HardlightVR/HL-hardware/Fabrics/NULLSPACEVR-TECH-PACK.pdf

CATEGORY | PRODUCT | | DATE | 2/20/16 | FABRICATION | 1 TRIMS | YKK 17" ZIP X1
HAPTIC WEAR | MARK IIc CONCEPT | JACKET | M/F | N/A | | 2 | 1 1/2" WIDE FLAT RIBBON
PRODUCTION FACILITY | | | SIZES | OS | | 3 | 2" WIDE VELCRO
| | | | | | | 2" WIDE ELASTIC

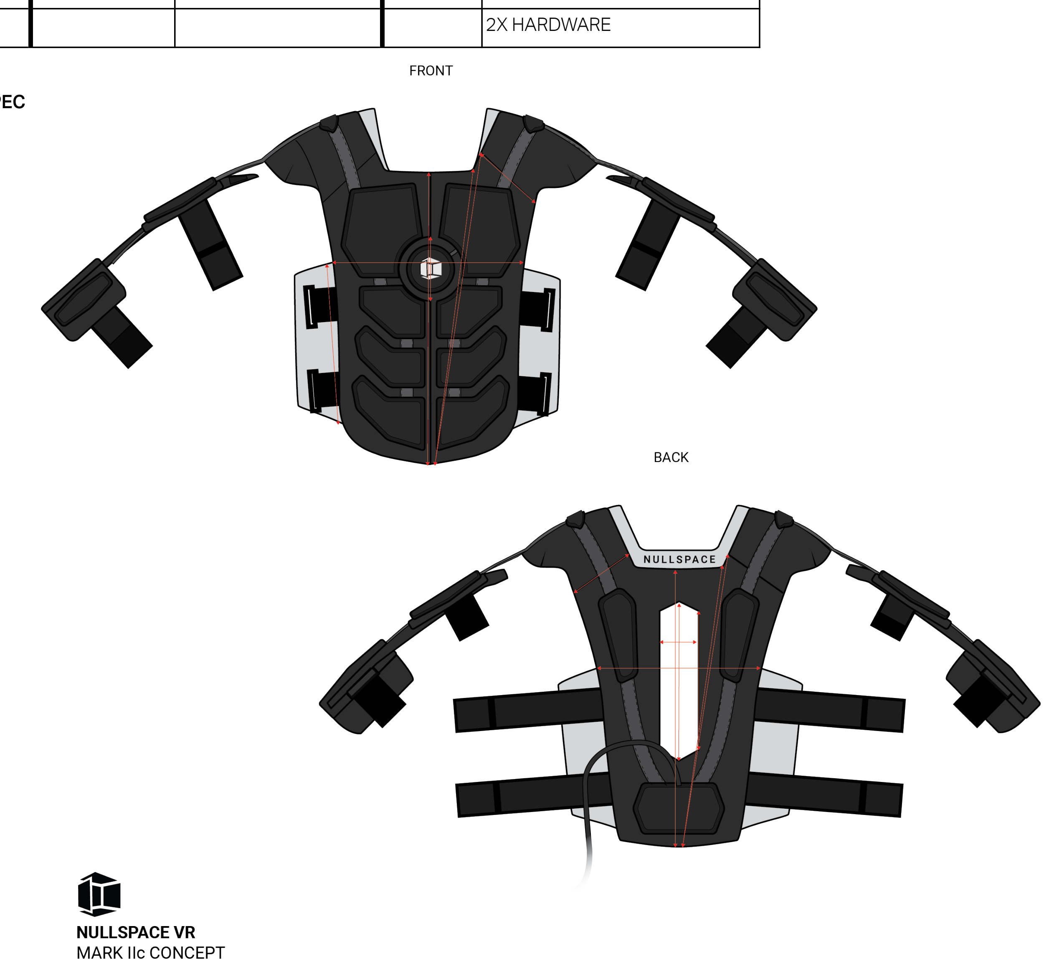
[picture p1: figure]
2X HARDWARE

INCHES | 1st FIT | APPROVED SPEC
CENTER FRONT NECK TO HEM | 17
BODY LENGTH TO CORNER NECK (FRONT) | 17 3/8
BODY LENGTH TO SHOULDERS (FRONT) | 19 3/4
CENTER BACK NECK TO HEM | 15 7/8
BODY LENGTH TO CORNER NECK (BACK) | 16 1/4
BODY LENGTH TO SHOULDERS (BACK) | 18 1/4
ACROSS SHOULDERS (WIDEST POINT) | 6
CHEST AT 6" FROM RAGLAN SHOULDER SEAM FRONT | 10.5
CHEST AT 6" FROM RAGLAN SHOULDER SEAM BACK | 9 3/4
SHOULDER PANEL RAGLAN SEAM FRONT | 3.5
SHOULDER PANEL RAGLAN SEAM BACK | 3.5
BACK DIAMOND OPENING WIDTH | 2 5/8
BACK DIAMOND OPENING CENTER LENGTH | 9
BACK DIAMOND OPENING EDGE LENGTH | 7.5
SEAM ALLOWANCE | 1/2
EXCEPT: OUTSIDE EDGES | 3/8"

### NULL SPACE VR

### MEASUREMENT (SEAM TO SEAM)
