HardlightVR/HL-hardware/Cables/Cable BOM.xlsx

Shorthand | Description | Digikey # | Manufacturer | Manufacturer #
16 pin header | CONN PLUG DUAL 16CKT BEIGE | WM13364-ND | Molex | 5031491600
8 pin header | CONN PLUG DUAL 8POS BEIGE | WM13361-ND | Molex | 5031490800
6 pin header, 2mm spacing | CONN PLUG HOUSING 6POS 2.00MM | WM2275-ND | Molex | 5024390600
4 pin header | CONN PLUG HSG 4CKT BEIGE | WM13352-ND | Molex | 5025780400
little crimps | CONN PLUG TERM 24-28AWG | WM9735CT-ND | Molex | 5025790000
big crimps for 6 pin | CONN TERM PLUG 22-26AWG CRIMP | WM3978CT-ND | Molex | 5024380000
TE 2 pin header for motors | CONN RECPT 2POS .1" POL UNLOAD | A28393-ND | TE Connectivity | 104257-1
TE crimp socket | CONN SOCKET 22-26AWG TIN CRIMP | A100411CT-ND | TE Connectivity | 1-104480-7
