HardlightVR/HL-hardware/Backpack Adapters/MSI/Backpack_Assm.SLDASM

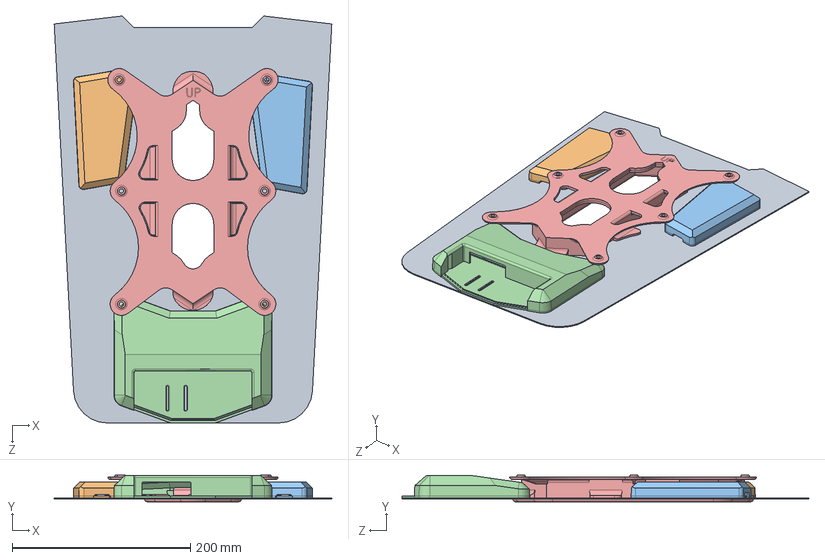
[picture p2: CAD file, 2019-01-10]
Backpack Adapters/MSI/Backpack_Assm.SLDASM
311.9 x 29.8 x 457.2 mm
Back_plate_guess
UpperBack_L
UpperBack_R
Lower Back_forWireless
MSI
