HardlightVR/HL-hardware/Backpack Adapters/HP OMEN/hp_adapter_plate.stl

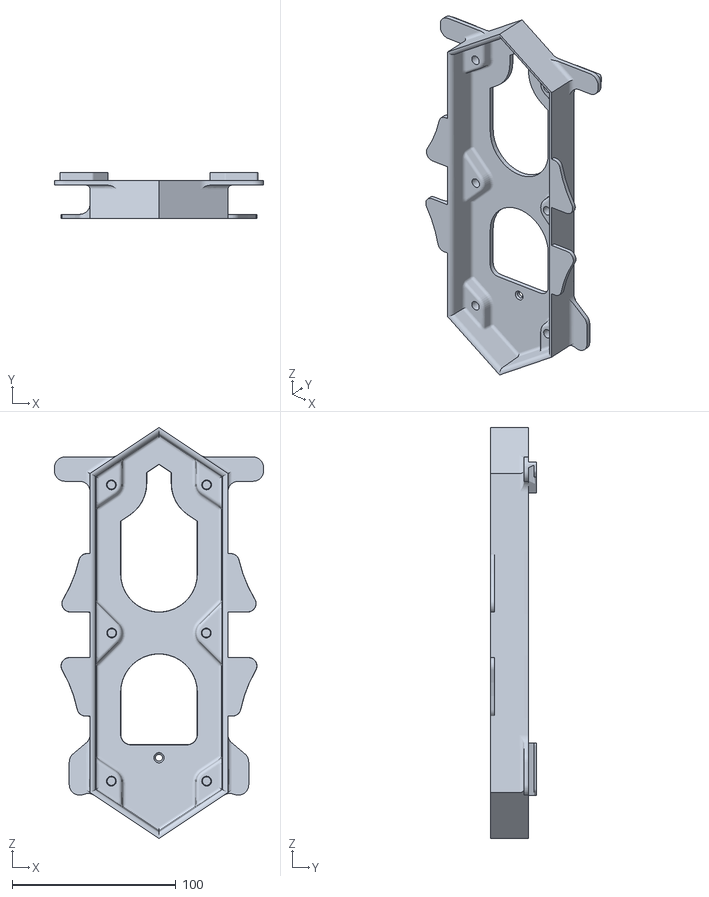
[picture p3: CAD file, 2019-01-10]
Backpack Adapters/HP OMEN/hp_adapter_plate.stl
127.7 x 28.0 x 250.9
