HardlightVR/HL-hardware/Backpack Adapters/ZOTAC/Zotac_Adapter.STL

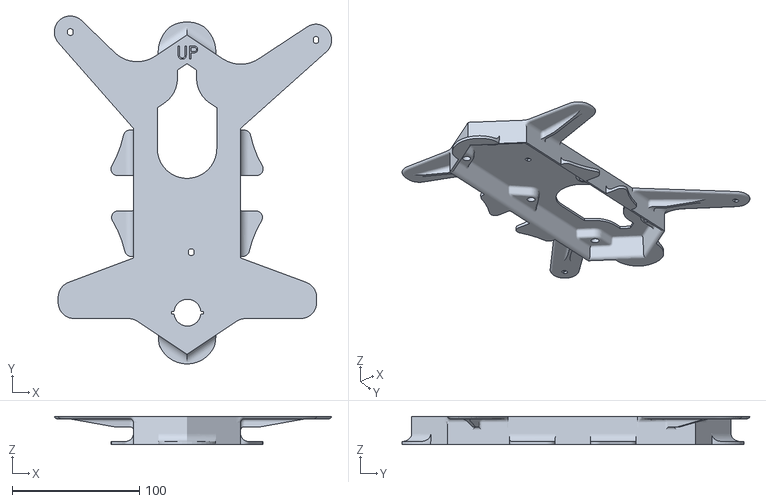
[picture p4: CAD file, 2019-01-10]
Backpack Adapters/ZOTAC/Zotac_Adapter.STL
218.0 x 273.4 x 22.3
