HardlightVR/HL-hardware/Final Plastics/UpperBack_L_cover.STEP

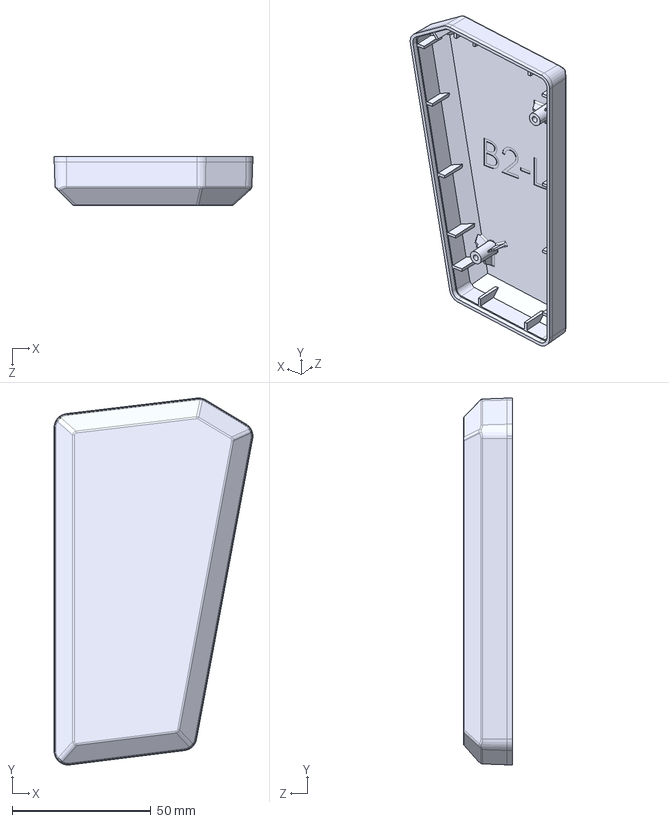
[picture p5: CAD file, 2019-01-10]
Final Plastics/UpperBack_L_cover.STEP
71.8 x 132.4 x 17.8 mm
