HardlightVR/HL-hardware/Prototype Plastics/Assem chest middle.STEP

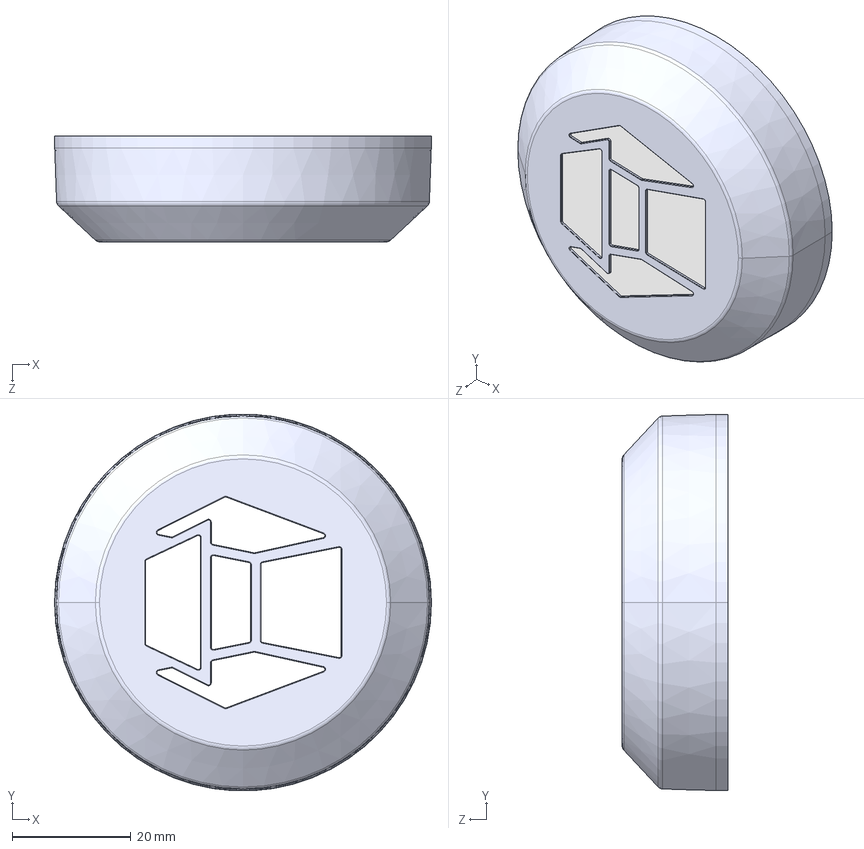
[picture p6: CAD file, 2019-01-10]
Prototype Plastics/Assem chest middle.STEP
63.4 x 63.3 x 17.8 mm
Chest_Middle_cover___
Chest_Middle_cover_glass___
