HardlightVR/HL-hardware/Prototype Plastics/VR 3d drawing-0815/assem shoulder.STEP

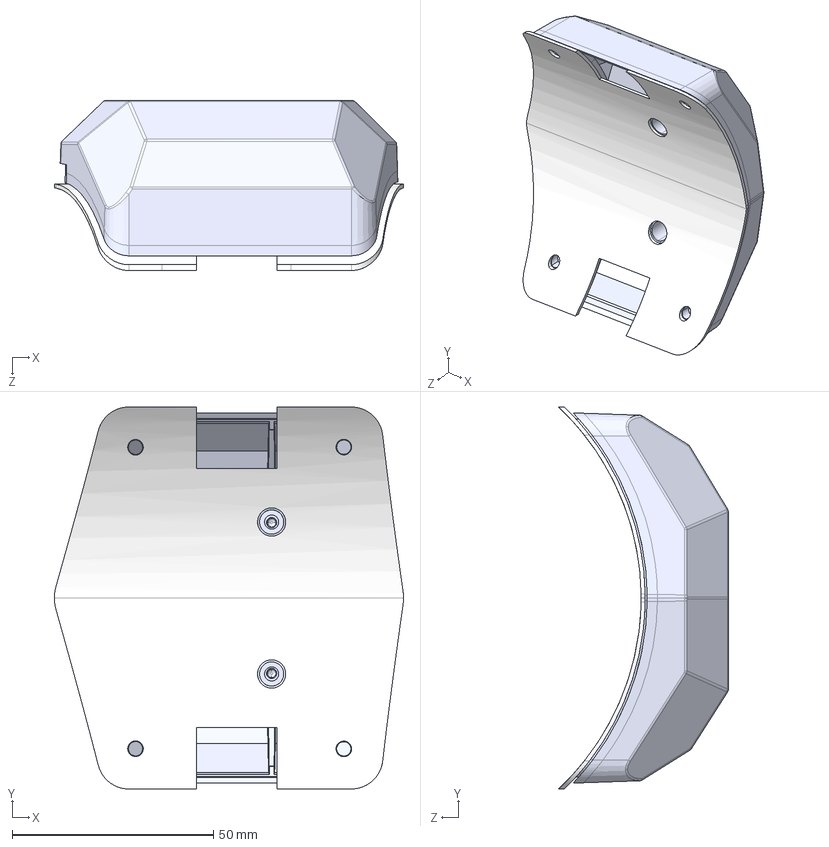
[picture p7: CAD file, 2019-01-10]
Prototype Plastics/VR 3d drawing-0815/assem shoulder.STEP
86.7 x 94.8 x 42.2 mm
Shoulder_base___
Shoulder_cover___
shoulder_Stif___
