HardlightVR/HL-hardware/Backpack Adapters/HP OMEN/hp_adapter_plate_latch.stl

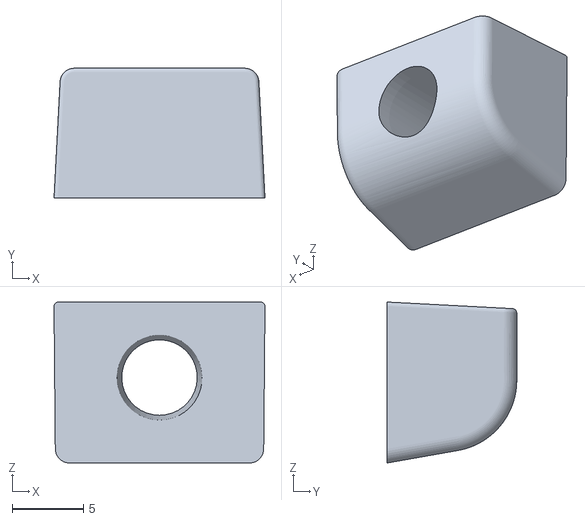
[picture p8: CAD file, 2019-01-10]
Backpack Adapters/HP OMEN/hp_adapter_plate_latch.stl
14.8 x 9.10 x 11.3
