HardlightVR/HL-hardware/Backpack Adapters/MSI/UpperBack_R.SLDPRT

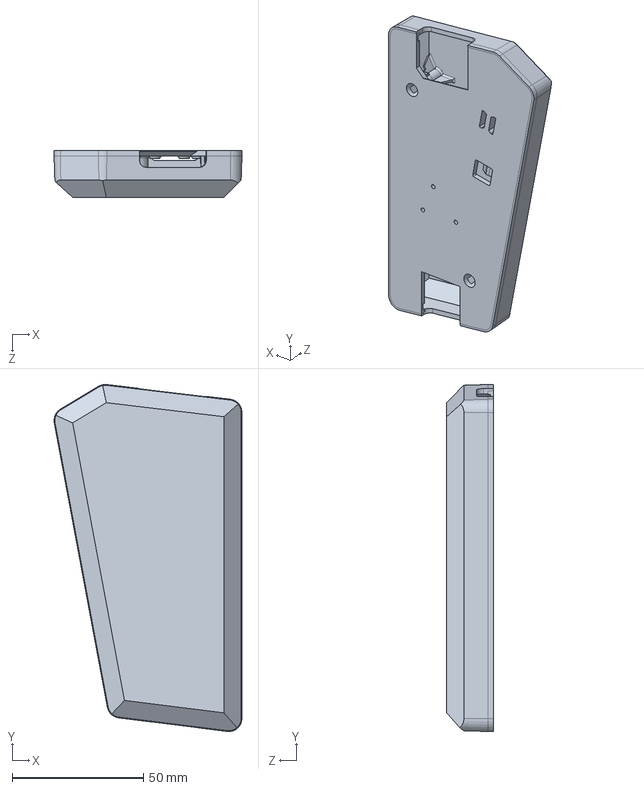
[picture p9: CAD file, 2019-01-10]
Backpack Adapters/MSI/UpperBack_R.SLDPRT
71.7 x 132.3 x 17.8 mm
