HardlightVR/HL-hardware/Backpack Adapters/ZOTAC/Zotac_Clamp.STL

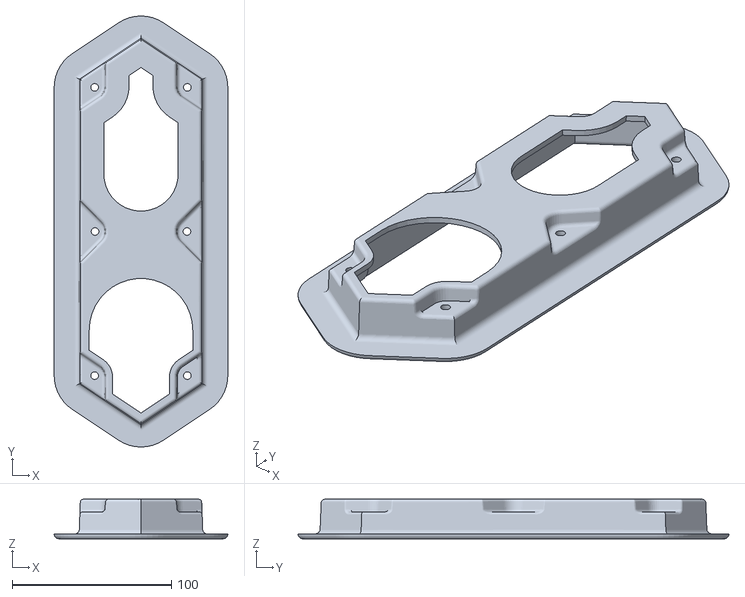
[picture p10: CAD file, 2019-01-10]
Backpack Adapters/ZOTAC/Zotac_Clamp.STL
109.0 x 270.5 x 24.8
