HardlightVR/HL-hardware/Prototype Plastics/Assem upper back_R.STEP

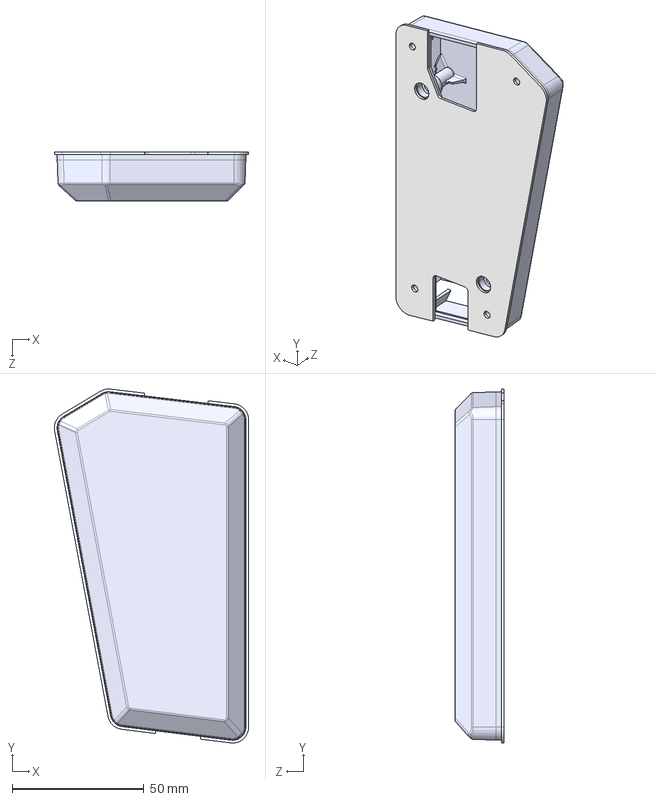
[picture p11: CAD file, 2019-01-10]
Prototype Plastics/Assem upper back_R.STEP
73.8 x 134.5 x 18.8 mm
UpperBack_L_base_R
UpperBack_L_cover-170629_R
UpperBack_L_Stif___
