HardlightVR/HL-hardware/Backpack Adapters/MSI/Lower Back_forWireless.SLDPRT

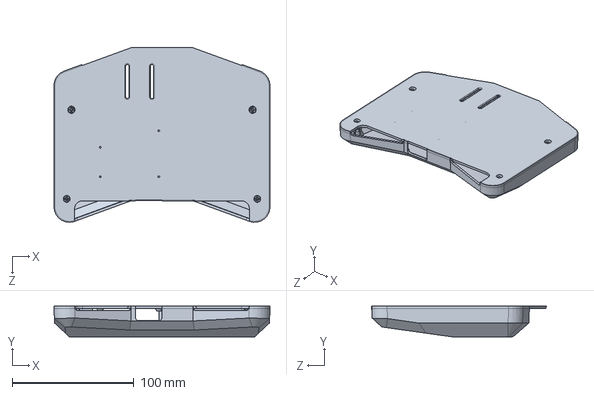
[picture p12: CAD file, 2019-01-10]
Backpack Adapters/MSI/Lower Back_forWireless.SLDPRT
177.7 x 25.4 x 143.7 mm
