HardlightVR/HL-hardware/Prototype Plastics/VR 3d drawing-0815/Assem lowerback.STEP

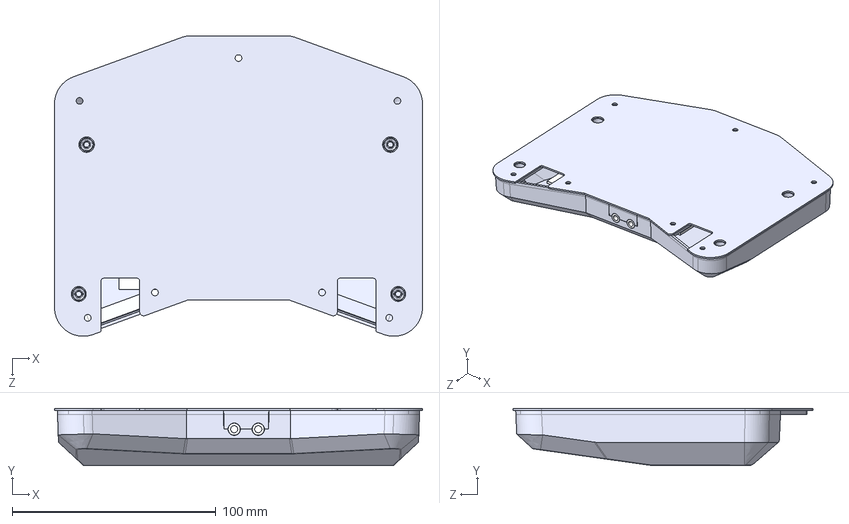
[picture p13: CAD file, 2019-01-10]
Prototype Plastics/VR 3d drawing-0815/Assem lowerback.STEP
180.6 x 28.0 x 147.5 mm
Lower Back_forWireless-base
Lower Back_forWireless-cover
MAIN PCBA___
lower back forWireless-Stif
