HardlightVR/HL-hardware/Backpack Adapters/MSI/Back_plate_guess.SLDPRT

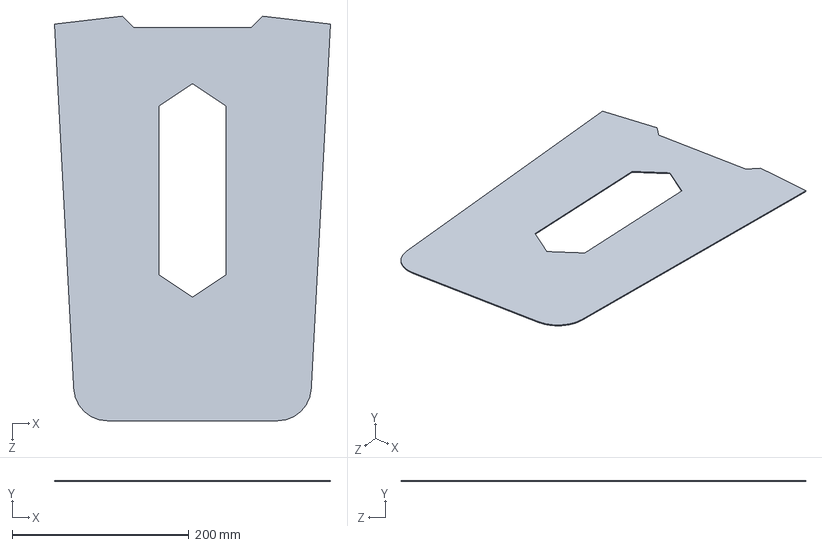
[picture p14: CAD file, 2019-01-10]
Backpack Adapters/MSI/Back_plate_guess.SLDPRT
311.9 x 1.27 x 457.2 mm
