HardlightVR/HL-hardware/Final Plastics/TopAb_L_Stif.STEP

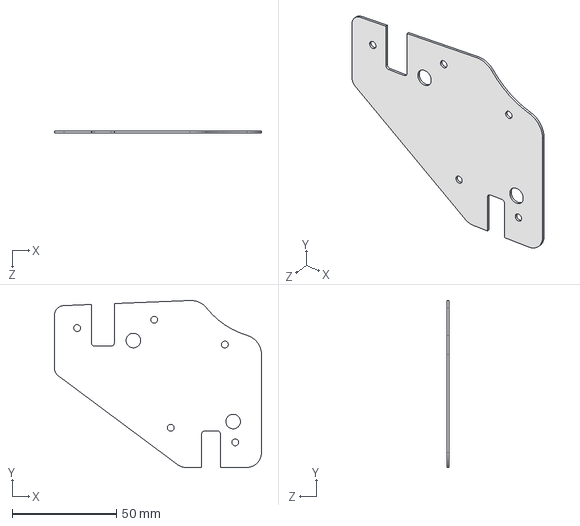
[picture p15: CAD file, 2019-01-10]
Final Plastics/TopAb_L_Stif.STEP
99.5 x 80.3 x 1.00 mm
