HardlightVR/HL-hardware/Prototype Plastics/VR 3d drawing-0815/Assm arm.STEP

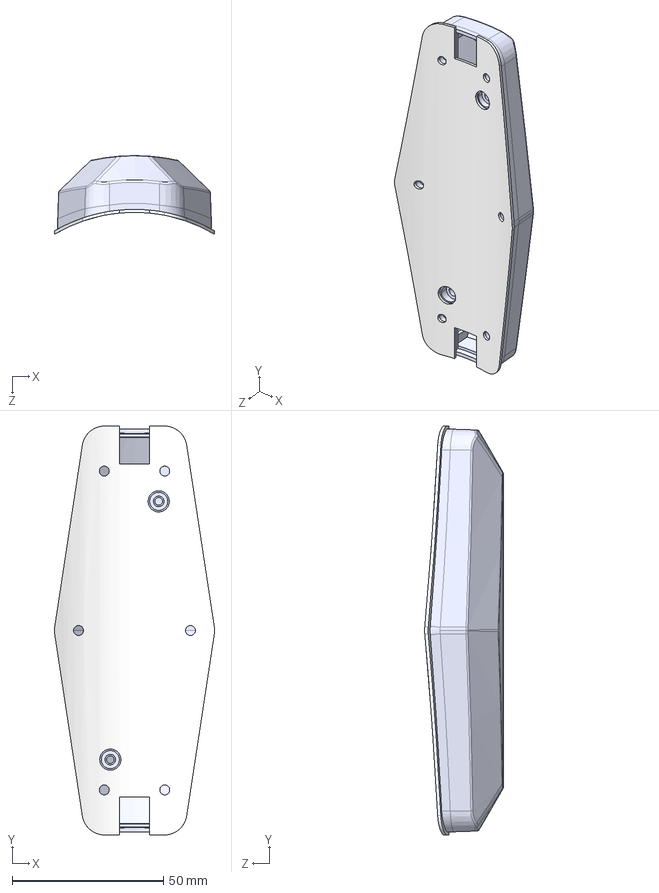
[picture p16: CAD file, 2019-01-10]
Prototype Plastics/VR 3d drawing-0815/Assm arm.STEP
53.0 x 135.2 x 26.1 mm
Arm_base___
Arm_cover___
vibration motor___
Arm_Stif___
