HardlightVR/HL-hardware/Final Plastics/BotAb_L_cover.STEP

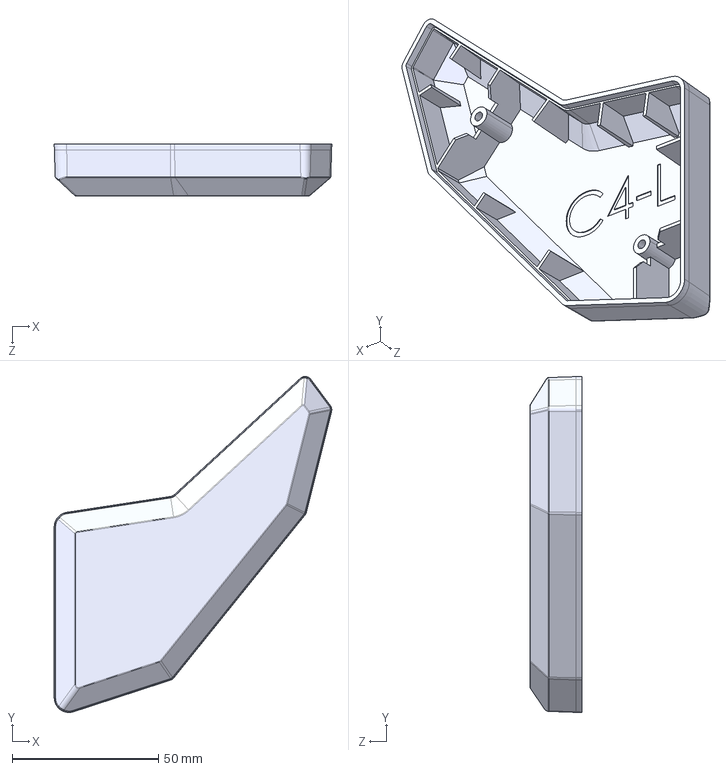
[picture p17: CAD file, 2019-01-10]
Final Plastics/BotAb_L_cover.STEP
95.0 x 115.0 x 17.8 mm
