HardlightVR/HL-hardware/Final Plastics/Shoulder_cover.STEP

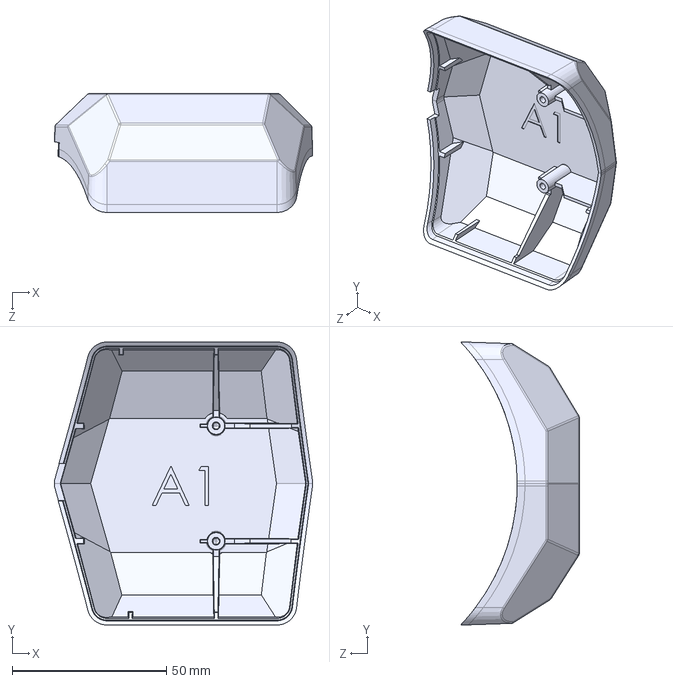
[picture p18: CAD file, 2019-01-10]
Final Plastics/Shoulder_cover.STEP
83.8 x 91.8 x 38.6 mm
