HardlightVR/HL-hardware/Final Plastics/UpperBack_L_Stif.STEP

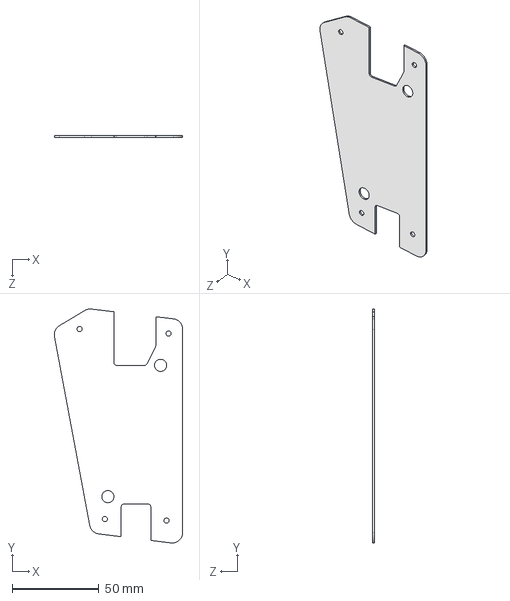
[picture p19: CAD file, 2019-01-10]
Final Plastics/UpperBack_L_Stif.STEP
73.8 x 134.5 x 1.00 mm
