HardlightVR/HL-hardware/Final Plastics/TopAb_L_base.STEP

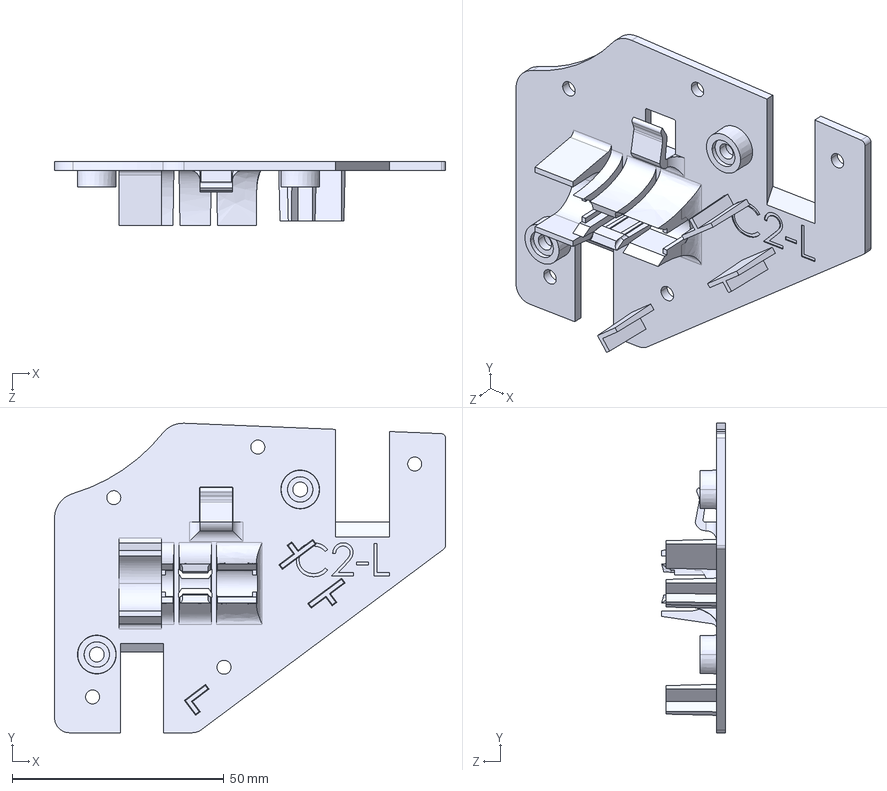
[picture p20: CAD file, 2019-01-10]
Final Plastics/TopAb_L_base.STEP
92.2 x 73.0 x 15.0 mm
