HardlightVR/HL-hardware/Final Plastics/Chest_R_Stif.STEP

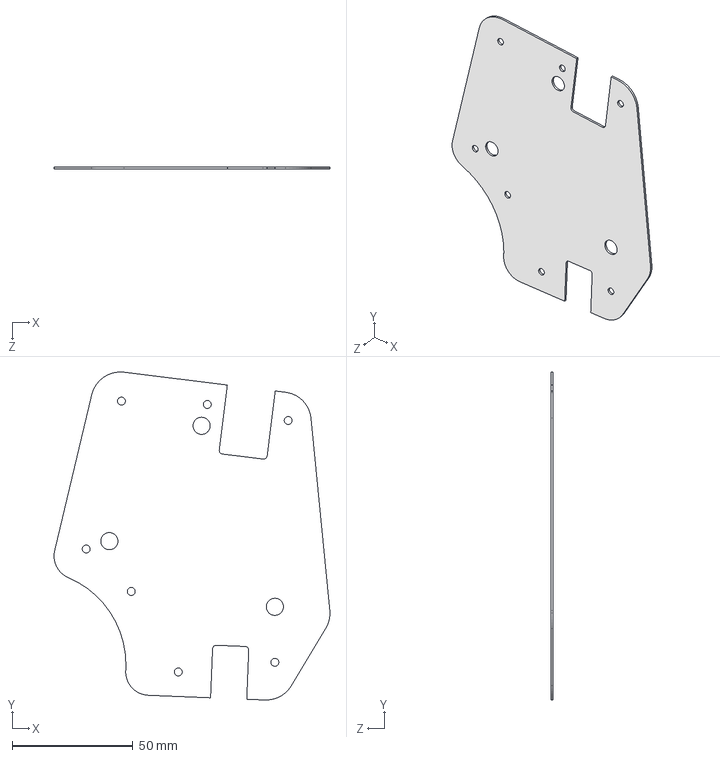
[picture p21: CAD file, 2019-01-10]
Final Plastics/Chest_R_Stif.STEP
114.3 x 135.9 x 1.00 mm
