HardlightVR/HL-hardware/Final Plastics/BotAb_L_Stif.STEP

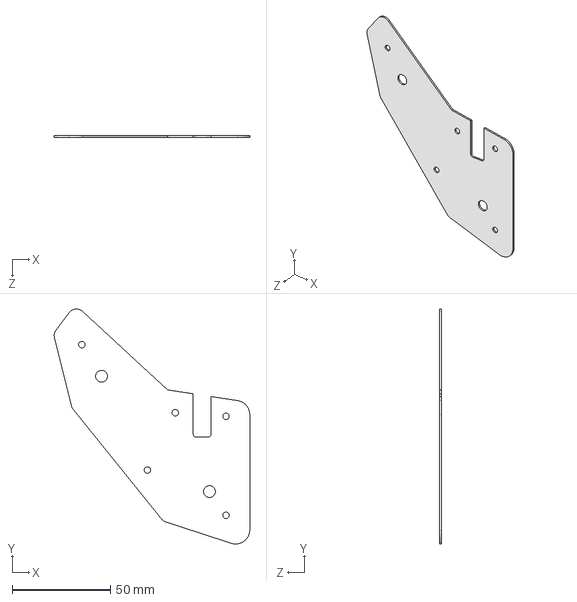
[picture p22: CAD file, 2019-01-10]
Final Plastics/BotAb_L_Stif.STEP
99.3 x 119.3 x 1.00 mm
