HardlightVR/HL-hardware/Final Plastics/Chest_Middle_Stif.STEP

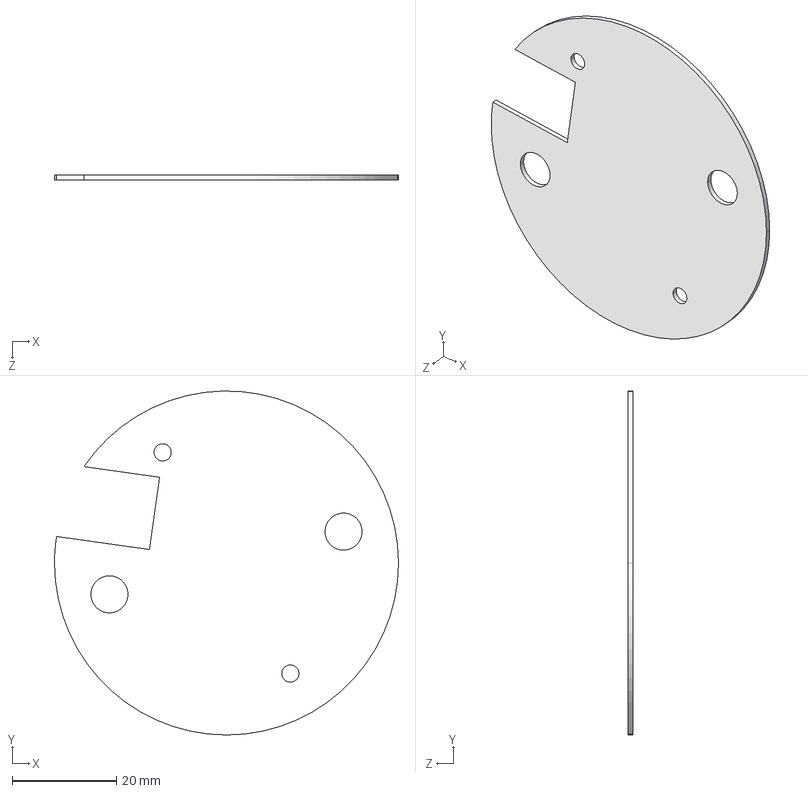
[picture p23: CAD file, 2019-01-10]
Final Plastics/Chest_Middle_Stif.STEP
66.0 x 66.0 x 1.00 mm
