HardlightVR/HL-hardware/Final Plastics/BotAb_R_base.STEP

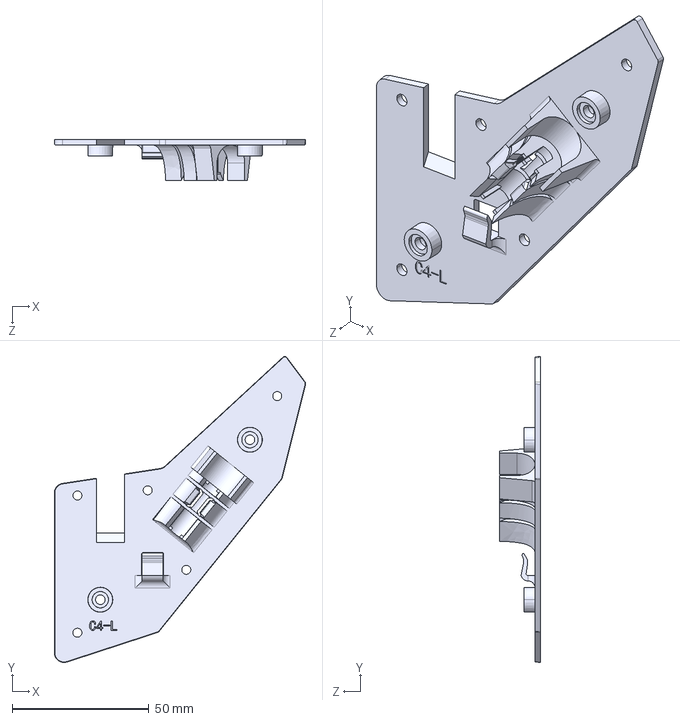
[picture p24: CAD file, 2019-01-10]
Final Plastics/BotAb_R_base.STEP
92.1 x 112.1 x 15.0 mm
