HardlightVR/HL-hardware/Final Plastics/MidAb_L_base.STEP

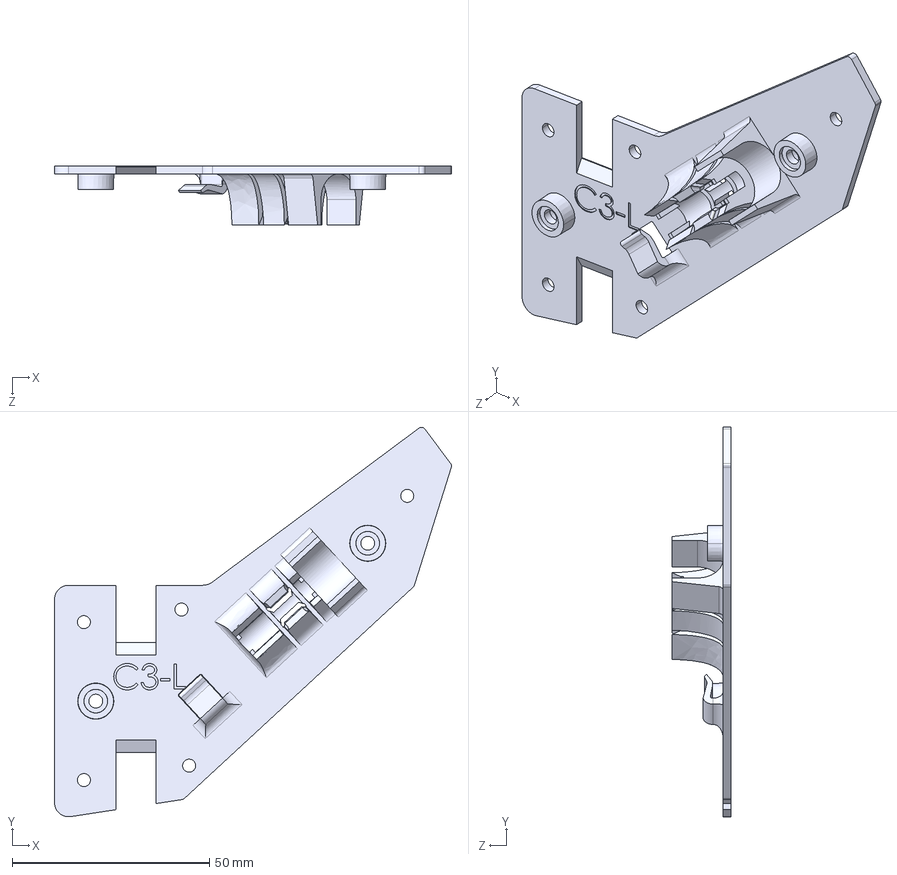
[picture p26: CAD file, 2019-01-10]
Final Plastics/MidAb_L_base.STEP
100.5 x 98.6 x 15.0 mm
