HardlightVR/HL-hardware/Final Plastics/MidAb_L_Stif.STEP

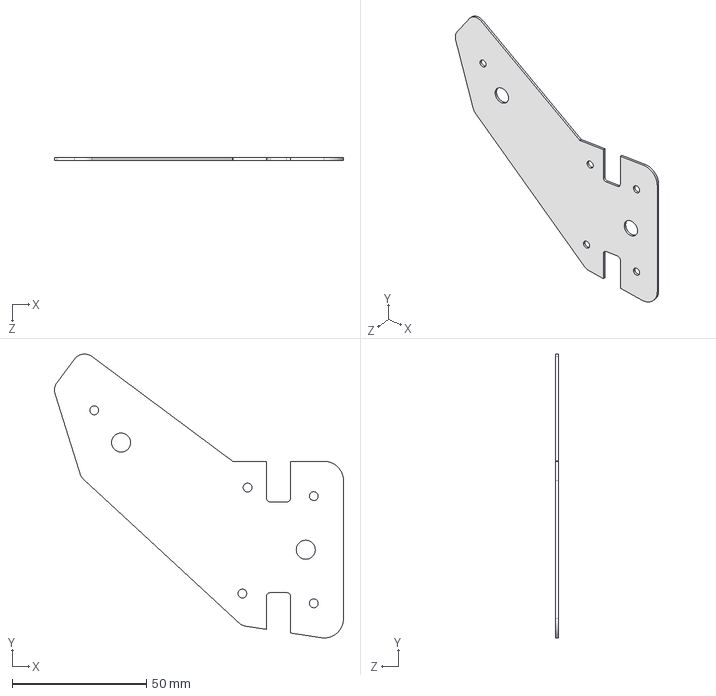
[picture p27: CAD file, 2019-01-10]
Final Plastics/MidAb_L_Stif.STEP
107.8 x 105.9 x 1.00 mm
