HardlightVR/HL-hardware/Final Plastics/Arm_cover.STEP

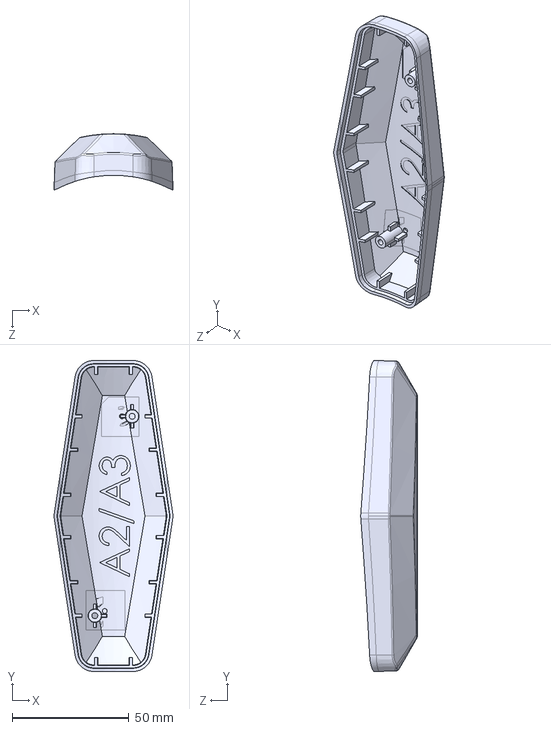
[picture p28: CAD file, 2019-01-10]
Final Plastics/Arm_cover.STEP
50.9 x 133.2 x 24.2 mm
