HardlightVR/HL-hardware/Final Plastics/TopAb_L_cover.STEP

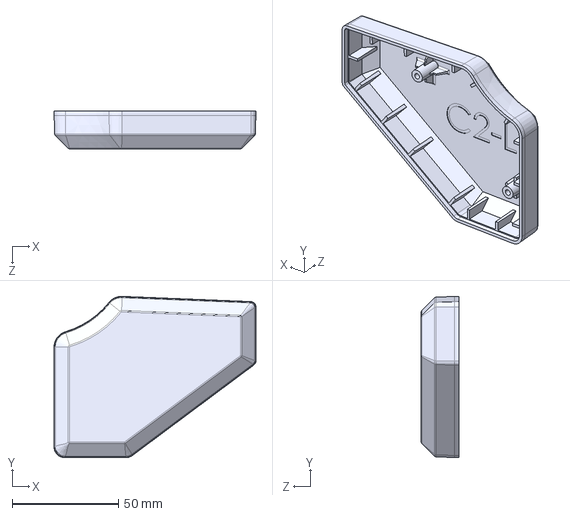
[picture p29: CAD file, 2019-01-10]
Final Plastics/TopAb_L_cover.STEP
95.2 x 76.0 x 17.8 mm
