HardlightVR/HL-hardware/Final Plastics/MidAb_R_cover.STEP

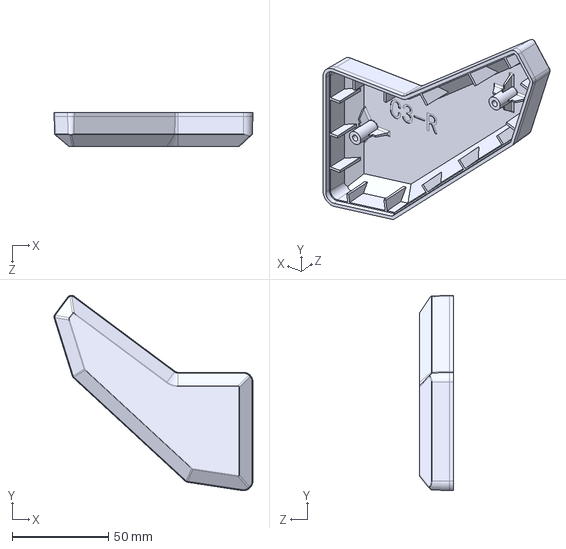
[picture p30: CAD file, 2019-01-10]
Final Plastics/MidAb_R_cover.STEP
103.5 x 101.6 x 17.8 mm
