HardlightVR/HL-hardware/Final Plastics/Shoulder_base.STEP

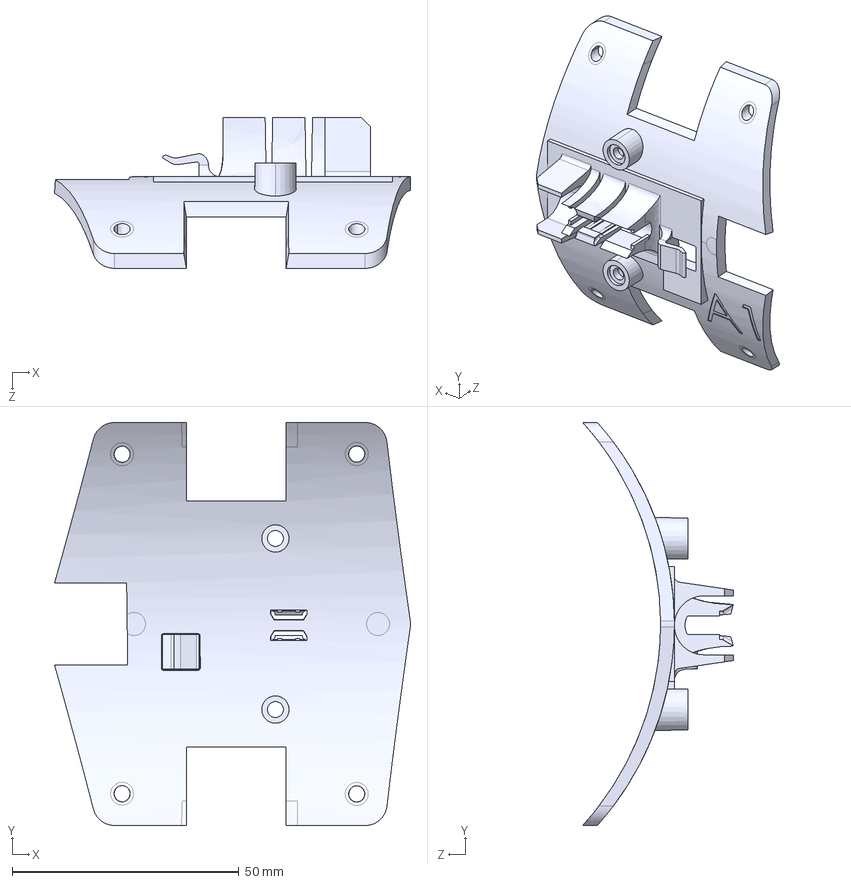
[picture p31: CAD file, 2019-01-10]
Final Plastics/Shoulder_base.STEP
78.5 x 88.8 x 33.2 mm
