HardlightVR/HL-hardware/Final Plastics/shoulder_Stif.STEP

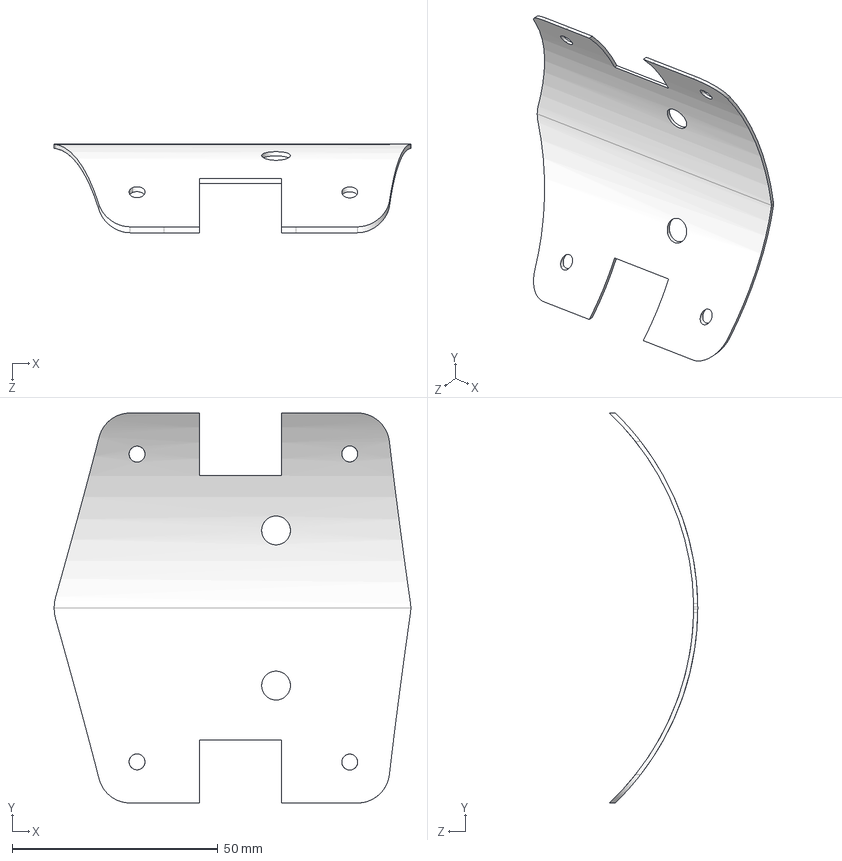
[picture p33: CAD file, 2019-01-10]
Final Plastics/shoulder_Stif.STEP
86.7 x 94.8 x 21.5 mm
