HardlightVR/HL-hardware/Final Plastics/Arm_base.STEP

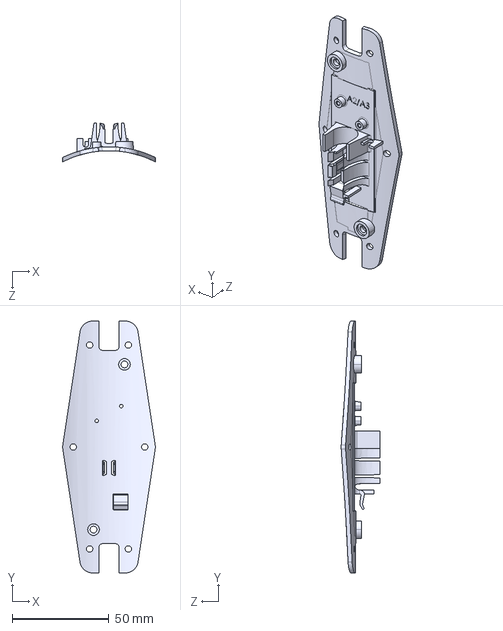
[picture p34: CAD file, 2019-01-10]
Final Plastics/Arm_base.STEP
47.9 x 130.3 x 20.0 mm
