HardlightVR/HL-hardware/Final Plastics/Chest_Middle_cover.STEP

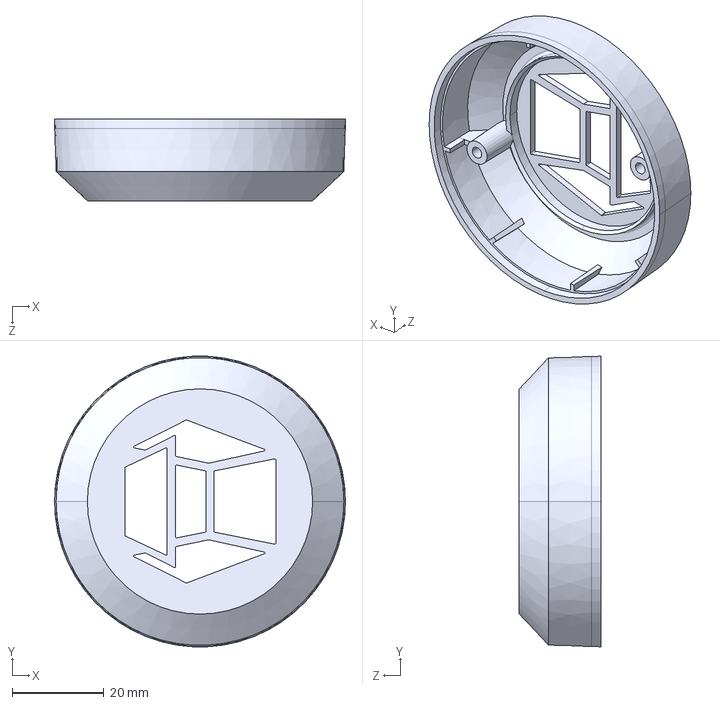
[picture p35: CAD file, 2019-01-10]
Final Plastics/Chest_Middle_cover.STEP
63.4 x 63.3 x 17.8 mm
