HardlightVR/HL-hardware/Final Plastics/Arm_Stif.STEP

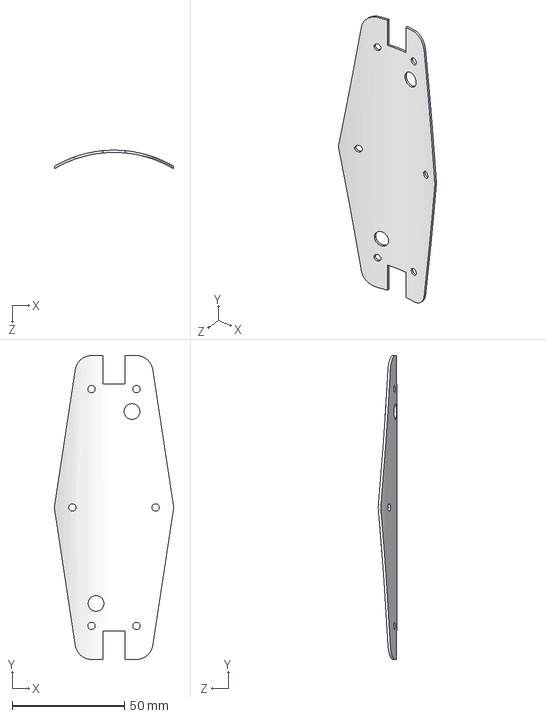
[picture p36: CAD file, 2019-01-10]
Final Plastics/Arm_Stif.STEP
53.0 x 135.2 x 8.25 mm
