HardlightVR/HL-hardware/Final Plastics/Chest_L_base.STEP

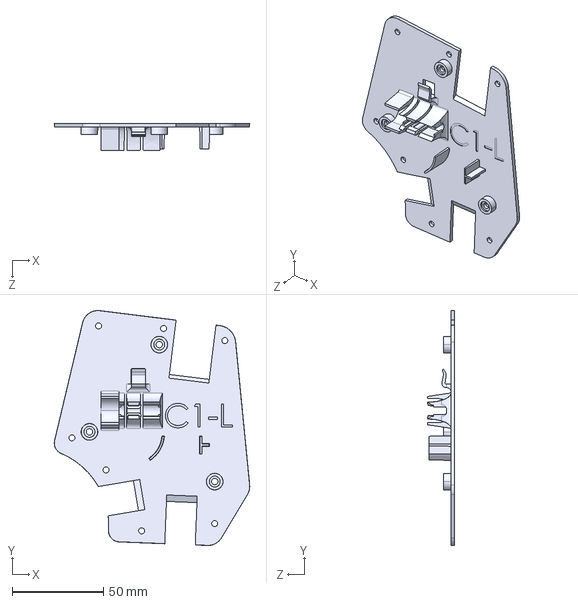
[picture p37: CAD file, 2019-01-10]
Final Plastics/Chest_L_base.STEP
107.1 x 128.7 x 15.0 mm
