HardlightVR/HL-hardware/Final Plastics/Chest_Middle_base.STEP

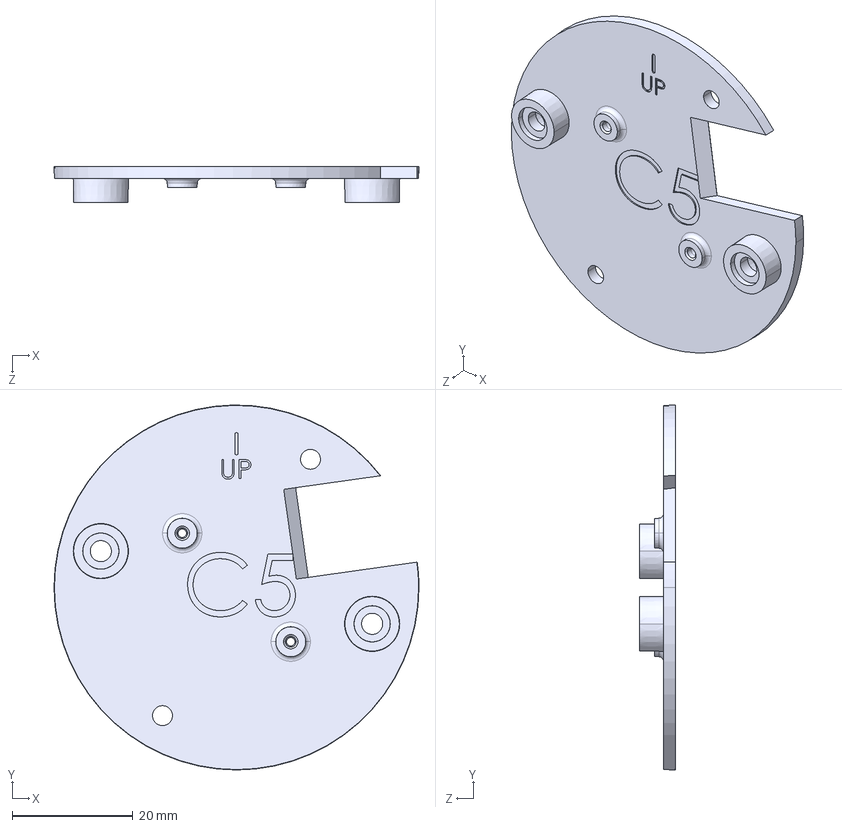
[picture p38: CAD file, 2019-01-10]
Final Plastics/Chest_Middle_base.STEP
60.4 x 60.4 x 6.03 mm
