HardlightVR/HL-hardware/Final Plastics/Chest_Middle_cover_glass.STEP

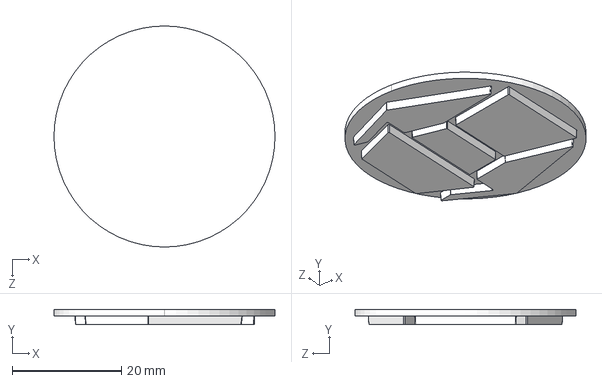
[picture p39: CAD file, 2019-01-10]
Final Plastics/Chest_Middle_cover_glass.STEP
40.5 x 2.70 x 40.5 mm
