HardlightVR/HL-hardware/Final Plastics/Chest_L_cover.STEP

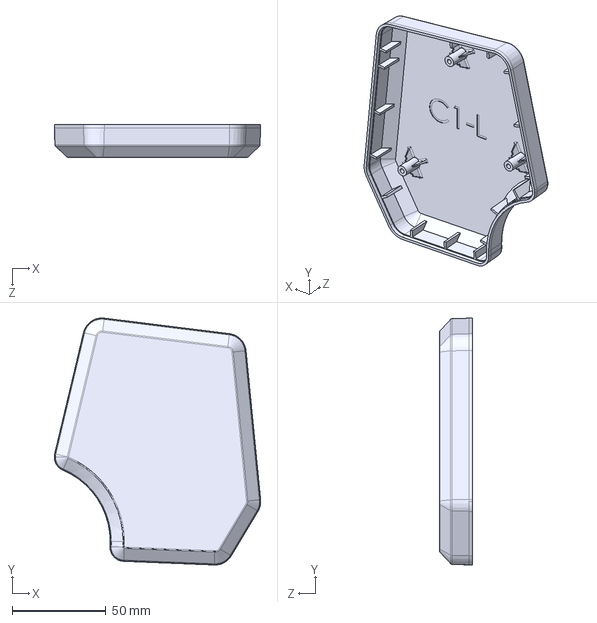
[picture p40: CAD file, 2019-01-10]
Final Plastics/Chest_L_cover.STEP
110.0 x 131.6 x 17.8 mm
