HardlightVR/HL-hardware/(list of files, cad)

Other CAD files:
Prototype Plastics/VR 3d drawing-0815/Assem upper back_L.STEP
Backpack Adapters/MSI/UpperBack_L.SLDPRT
Final Plastics/TopAb_R_base.STEP
Final Plastics/MidAb_R_base.STEP
Final Plastics/TopAb_R_cover.STEP
Final Plastics/Assem upper back_L.STEP
Final Plastics/MidAb_L_cover.STEP
Final Plastics/BotAb_R_cover.STEP
Final Plastics/UpperBack_L_base.STEP
Final Plastics/BotAb_L_base.STEP
Final Plastics/Chest_R_cover.STEP
Final Plastics/UpperBack_R_cover.STEP
Final Plastics/Chest_L_Stif.STEP
