HardlightVR/HL-hardware/Fabrics/Sewing Instructions.pdf

CATEGORY | PRODUCT | | DATE | 2/20/16 | FABRICATION | 1 Black 210 Denier Coated Nylon Oxford Fabric | TRIMS | YKK 17" ZIP X1
HAPTIC WEAR | MARK IIc CONCEPT | JACKET | M/F | N/A | | 2 Medium Grey 200 Denier Coated Oxford Nylon Fabric | | 1 1/2" WIDE FLAT RIBBON
PRODUCTION FACILITY | | | SIZES | OS | | 3 Foam Batting | | 2" WIDE VELCRO
| | | | | | | | 2" WIDE ELASTIC
| | | | | | | | 2X HARDWARE
STEP | x
1 | 2 BODY
2 | 4
3 | 2
4 | 4
5 | 4
6 | 8
8 | 1 ZIPPER
9 | 2
10 | 2
11 | 2
12 | 1
13 | 3 BODY
14 | 1
15 | 2
16 | 1
17 | ARMS
18 | 2

## ELECTRONICS

## NULL SPACE VR

Hard casing placement and attachment Feed wires through the tunnels

| INSTRUCTION
| Sew outer edges of side flaps
| Sew darts closed on shoulder panels
| Plce velcro on interior shoulder panel(underside will connect to arm) and stitch down
| Sew shoulder panels to the front chest panel
| Sew shoulder panel to back chest panel
| Place flat ribbon trim (tunnels) and edge stitch down
7 | fold back and edge stitch the edges of all the ribbon trim that will become tunnels, for extra durability
| Sew outer edge of zipper placket to the center front panel
| Fold and press the placket
| Pin the zipper, inner fabric and outer fabric in place
| Stitch the zipper, and internior/exterior fabrics into place
| Sew the neckline edges closed
| Secure foam batting
| Sew interior and exterior of back panel together around the center back opening
| Pin side flaps, and trims (velcro on front, buckles on back) in to place
| Sew outside edges together to attach interior and exterior of chest and shoulder
| Place flat ribbon trim and edge stitch down on panel 6
| Sew together flat ribbon trim creating tunnel for wires connecting the shoulder panel and the top of the arm. Leave the bottom ribbon longer by about 1/2" that will be inserted into the seam between arm panles 2 and 3/4
19 | Leave the arm-end of this connecting tunnel free until step 29. The ribbon will be edge stitched onto panel 2 for about 1/2" and the bottom, longer ribbon will be instered into the seam as outlined above
20 | Pin trims (velcro and buckles) in to place (Panels 1, 3 and 4)
21 | Sew velcro onto outer panel 1
22 | Sew outer fabric modular panels together (panels 3 & 4)
23 | To connect all the arm segments, start at the top and work down
24 | Sew all outer edges of panel 1 except the bottom edge, interior and exterior fabrics together)
25 | Place panel 1 sandwiched between interior and exterior fabrics of panel 2 and sew all outer edges expect the bottom
26 | Sew outer side edges of panel 6, leaving the top and bottom edges open (end stitch line at 1/2" seam allowance for top and bottom edge)
27 | Attach external layer (face to face) of panel 6 with upper panels 3&4 combo and lower panels 3&4 combo
28 | Pin the finished panels 1 and 2, already connected, into place between upper panel 5 and 3&4 combo
29 | Sew outer edges of panel 5 to panels 3&4, upper and lower, leaving only the panel 6 open (this is where the segments wil be turned right-side out)
30 | Turn the arm sections right side out
31 | Hand finish or top stitch the open section at the being careful not to stich closed the flat ribbontunnel where the wires will be fed through
32
