HardlightVR/HL-hardware/Fabrics/Materials Guide.pdf

CATEGORY | PRODUCT | | DATE | FABRICATION | 1 TRIMS | YKK 17" ZIP X1
HAPTIC WEAR | MARK IIc CONCEPT | JACKET | M/F | | 2 | 1 1/2" WIDE FLAT RIBBON
PRODUCTION FACILITY | | | SIZES | | 3 | 2" WIDE VELCRO
| | | | | | 2" WIDE ELASTIC
| | | | | | 2X HARDWARE
Item | Source | Cost Per Unit | Units Needed Per Suit Cost Bought? | # of suits | 2
2 in Anodized Black Flat Metal Slide | Strapworks | $0.55 | 2 $1.10 no | Total Cost - 1 suit $42.90 | 4 | $2.20 $87.20
2 in Anodized Black Metal Square Loop | Strapworks | $0.62 | 8 $4.96 no | | 16 | $9.92
Black 210 Denier Coated Nylon Oxford Fabric | Online Fabric Store | $4.75 | 2.5 $11.88 no | 5 $23.75
VELCRO® brand Loop Fastener 2" Sew-On Black - 5 Yard Roll Online Fabric Store | $6.30 | 0.5 $3.15 no | 1 | $6.30
VELCRO® brand Hook Fastener 2" Sew-On Black - 5 Yard Roll Online Fabric Store | $6.30 | 0.5 $3.15 no | 1 | $6.30
Fairfield Natural Cotton Batting | Online Fabric Store | $9.10 | 0.5 $4.55 no | | 1 | $9.10
3 1/4" White Dacron Upholstery Deck Padding | Online Fabric Store | $2.80 | 0.25 $0.70 no | | 1 | $2.80
1 Medium Grey 200 Denier Coated Oxford Nylon Fabric | Rockywoods | $5.99 | 1 $5.99 no | 2 $11.98
2 Black 2" Solution Dyed Nylon Webbing Mil 17337 Style 3220 Rockywoods | $1.65 | 4.5 $7.43 no | 9 $14.85
1/32” easy to machine polystyrene | McMaster-Carr | | $0.00

NULL SPACE VR
