HardlightVR/HL-hardware/Fabrics/STKW-Mark-IIcConcept-NULLSPACE-2.20.pdf

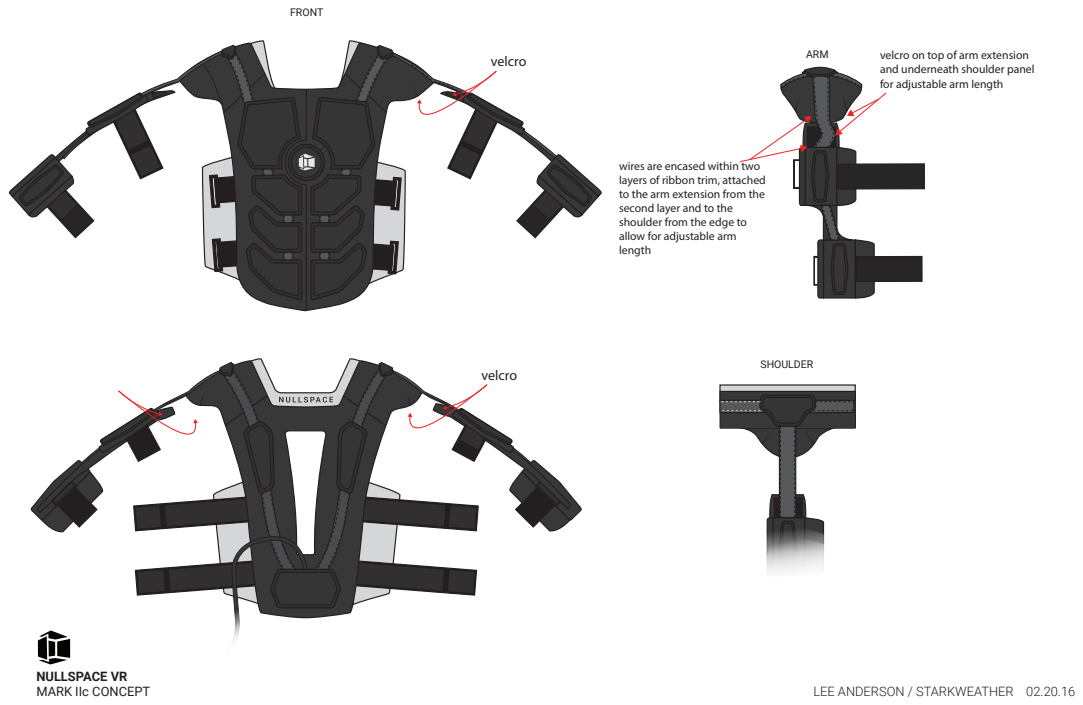
[picture p50: page 1]
NULLSPACE VR; MARK IIc CONCEPT; LEE ANDERSON / STARKWEATHER 02.20.16; SHOULDER; ARM; FRONT; velcro

velcro on top of arm extension
and underneath shoulder panel
for adjustable arm length

wires are encased within two
layers of ribbon trim, attached
to the arm extension from the
second layer and to the
shoulder from the edge to
allow for adjustable arm
length
