HardlightVR/HL-hardware/Fabrics/STKW-nullspace.pdf

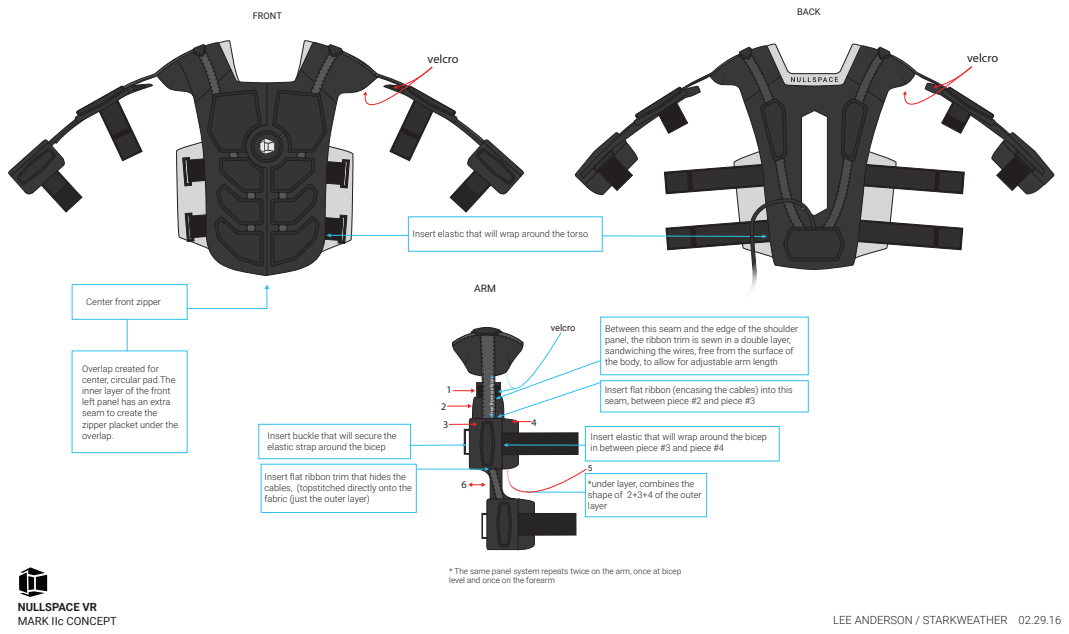
[picture p51: page 1]
FRONT; BACK; velcro; ARM; NULLSPACE VR; MARK IIc CONCEPT; LEE ANDERSON / STARKWEATHER 02.29.16

Insert elastic that will wrap around the torso

Center front zipper

Between this seam and the edge of the shoulder
panel, the ribbon trim is sewn in a double layer,
sandwiching the wires, free from the surface of
the body, to allow for adjustable arm length

Overlap created for
center, circular pad.The
inner layer of the front
left panel has an extra
seam to create the
zipper placket under the
overlap.

free from surface

Insert flat ribbon (encasing the cables) into this
seam, between piece #2 and piece #3

Insert buckle that will secure the
elastic strap around the bicep

Insert elastic that will wrap around the bicep
in between piece #3 and piece #4

*under layer, combines the
shape of 2+3+4 of the outer
layer

Insert flat ribbon trim that hides the
cables, (topstitched directly onto the
fabric (just the outer layer)

* The same panel system repeats twice on the arm, once at bicep
level and once on the forearm
