HardlightVR/HL-hardware/Fabrics/inner_pattern.pdf

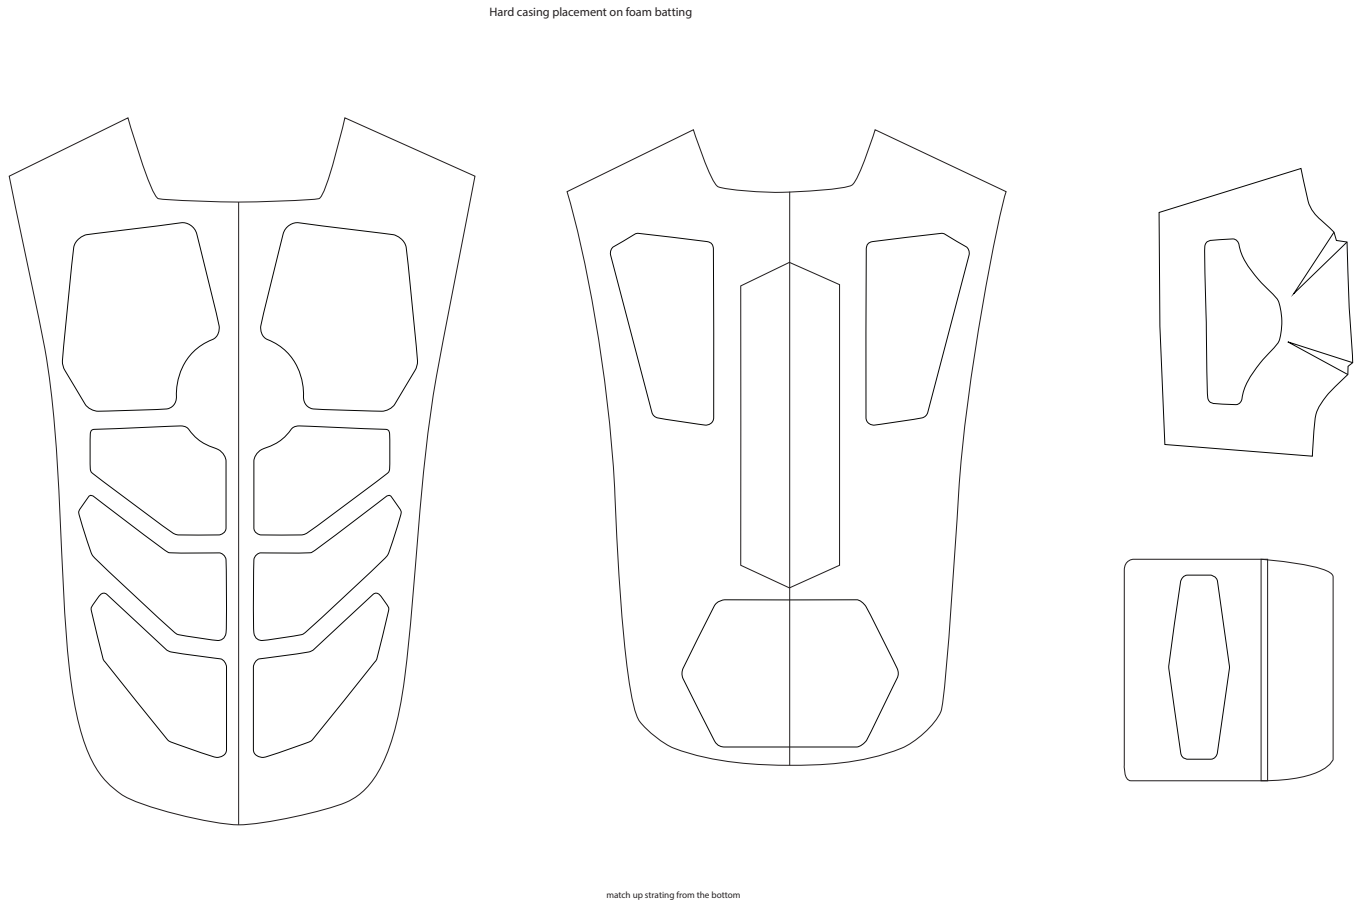
[picture p52: page 1]

Hard casing placement on foam batting

match up strating from the bottom
