HardlightVR/HL-hardware/(commit log)

2019-01-10 All assets collected
    [Arm_Stif.STEP, Arm_base.STEP, Arm_cover.STEP, Assem chest middle.STEP, Assem lowerback.STEP, Assem upper back_L.STEP, Assem upper back_R.STEP, Assm arm.STEP]
2019-01-10 dir rename for clarity
    [Arm_Stif.STEP, Arm_base.STEP, Arm_cover.STEP, Assem chest middle.STEP, Assem lowerback.STEP, Assem upper back_L.STEP, Assem upper back_R.STEP, Assm arm.STEP]
